mekanika-dev/dst/cad/DST-59 V2.1.step

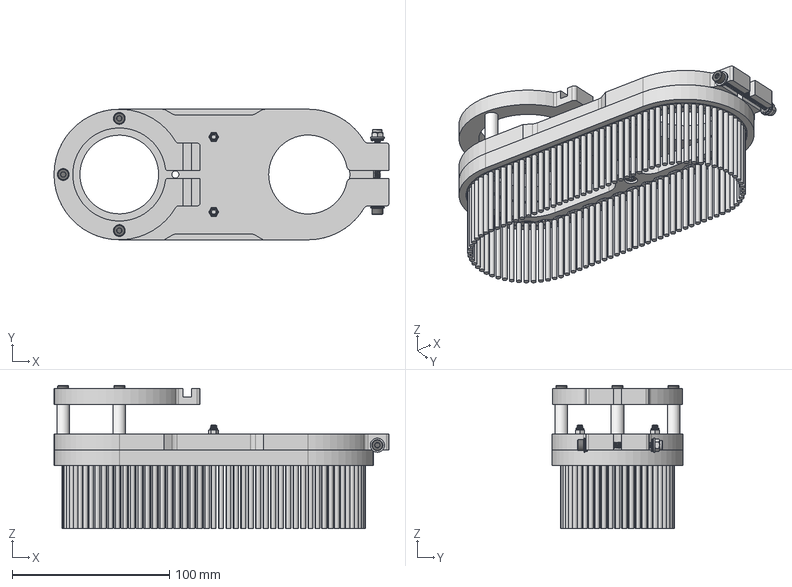
[picture p2: CAD file, 2026-09-30]
cad/DST-59 V2.1.step
212.9 x 83.0 x 91.0 mm
