mekanika-dev/dst/(commit log)

2026-02-12 Initial commit with all current files
2026-02-12 Update of the BOM: DST-43 V1.0
    SKU: M01425
    File: DST-43 V1.0.csv
    Synced at: Thu Feb 12 12:32:42 UTC 2026
    [DST-43 V1.0.csv]
2026-02-12 Update of the BOM: DST-59 V1.0
    SKU: M01426
    File: DST-59 V1.0.csv
    Synced at: Thu Feb 12 12:47:21 UTC 2026
    [DST-59 V1.0.csv]
2026-02-25 update to DST V2.0
    [DST-43 V1.0.csv, DST-59 V1.0.csv]
2026-02-25 Update of the BOM: DST-43 V2.0
    SKU: M01744
    File: DST-43 V2.0.csv
    Synced at: Wed Feb 25 11:13:06 UTC 2026
    [DST-43 V2.0.csv]
2026-02-25 Update of the BOM: DST-59 V1.0
    SKU: M01745
    Synced at: Wed Feb 25 11:15:20 UTC 2026
    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
    [DST-59 V1.0.csv]
2026-09-30 updated to v2.1
    [DST-43 V2.0.stp, DST-43 V2.1.step, DST-59 V2.0.stp, DST-59 V2.1.step]
2026-10-05 Update of the BOM: DST-43 V2.1
    SKU: M01816
    File: DST-43 V2.1.csv
    Synced at: Mon Oct 5 12:40:20 UTC 2026
    [DST-43 V2.1.csv]
2026-10-05 Update of the BOM: DST-59 V2.1
    SKU: M01817
    File: DST-59 V2.1.csv
    Synced at: Mon Oct 5 12:41:36 UTC 2026
    [DST-59 V2.1.csv]
2026-10-05 removed v2.0 BOM files
    [DST-43 V2.0.csv, DST-59 V1.0.csv]
